bjeong99/MazeTraversalRobot/docs/Lab2/nonINV.PNG

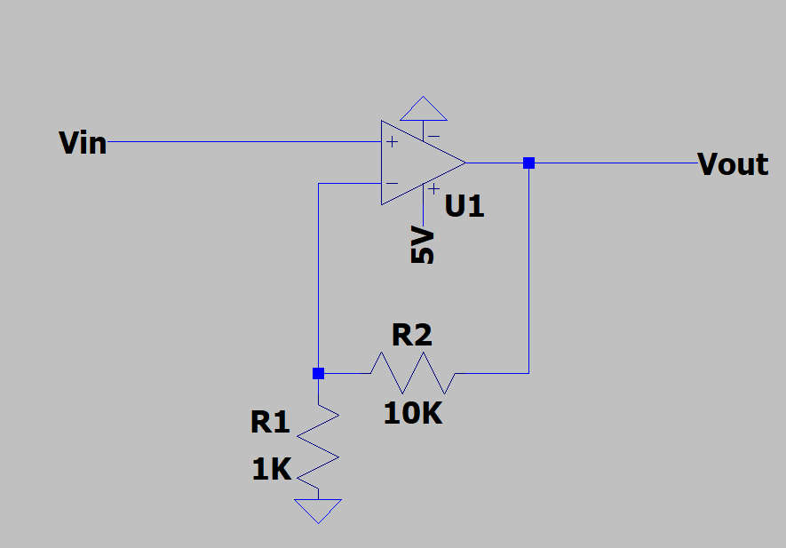
docs/Lab2/nonINV.PNG
