bjeong99/MazeTraversalRobot/(commit log)

2019-10-02 Added Two case statements to the code block
2019-10-09 Added blurb about our 3 circuits and added sch and plt
2019-12-09 DFS with robot detection, override button
2019-12-10 Most recent with not working maze drawing
    [milestone4v1.0.ino]
